mahir-m01/SIMD-Vector-Processing-Unit/reports/src/figures/fpga.pdf

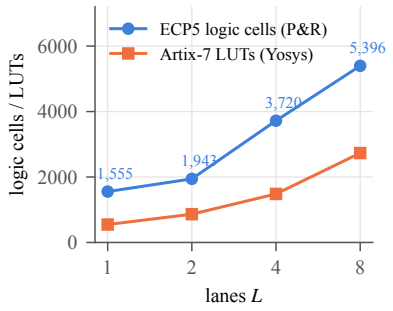
[picture p3: figure]
logic cells / LUTs; ECP5 logic cells (P&R) Artix-7 LUTs (Yosys)
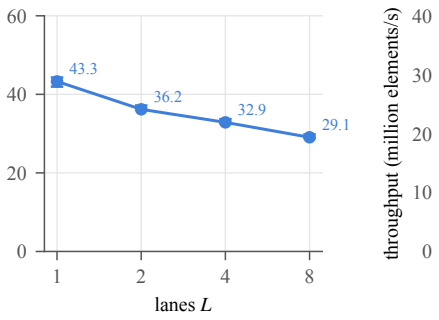
[picture p4: figure]
throughput (million elements/s)
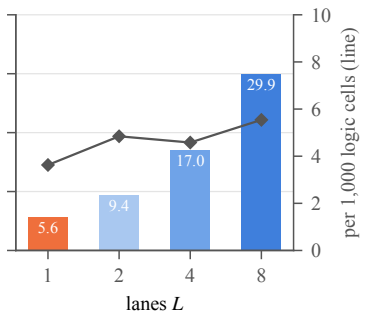
[picture p5: figure]
per 1,000 logic cells (line)

## Fmax on ECP5-25F (MHz)
