mahir-m01/SIMD-Vector-Processing-Unit/reports/src/figures/perf.pdf

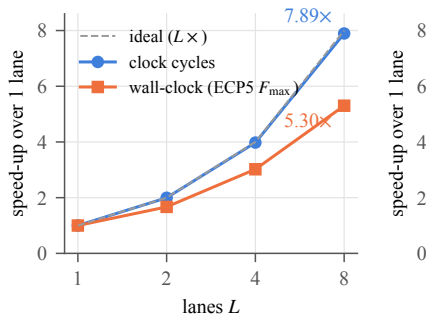
[picture p13: figure]
speed-up over 1 lane; ) clock cycles wall-clock (E C
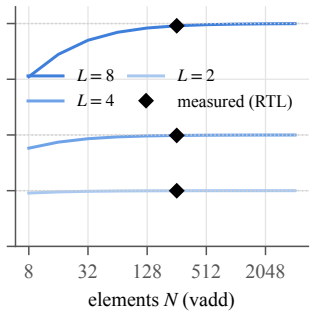
[picture p14: figure]
512 2048 elements N (vadd); 2 measured (RTL)

vadd | saxpy | relu threshold dot

0

1000

2000

## clock cycles (N = 256)

7.92×

7.90×
7.89×

7.87×
7.89×

1 lane (scalar)
2 lanes

4 lanes
8 lanes
