mahir-m01/SIMD-Vector-Processing-Unit/results/fpga_artix7.csv

lanes | luts | luts_total | lutram | flip_flops | flip_flops_total | dsp48 | dsp48_total | bram36_equiv | bram36_total | carry4
1 | 548 | 20800 | 22 | 42 | 41600 | 1 | 90 | 0.5 | 50 | 23
2 | 864 | 20800 | 28 | 42 | 41600 | 2 | 90 | 1.0 | 50 | 40
4 | 1483 | 20800 | 38 | 42 | 41600 | 4 | 90 | 2.0 | 50 | 74
8 | 2731 | 20800 | 60 | 43 | 41600 | 8 | 90 | 4.0 | 50 | 127
