mahir-m01/SIMD-Vector-Processing-Unit/results/fpga_ecp5.csv

lanes | logic_cells | logic_cells_total | flip_flops | lutram_blocks | multipliers | multipliers_total | block_ram | block_ram_total | fmax_mhz_median | fmax_mhz_min | fmax_mhz_max
1 | 1555 | 24288 | 16 | 26 | 1 | 28 | 2 | 56 | 43.29 | 41.96 | 44.29
2 | 1943 | 24288 | 16 | 34 | 2 | 28 | 3 | 56 | 36.19 | 36.13 | 37.17
4 | 3720 | 24288 | 16 | 50 | 4 | 28 | 5 | 56 | 32.87 | 32.67 | 33.69
8 | 5396 | 24288 | 16 | 82 | 8 | 28 | 9 | 56 | 29.07 | 28.85 | 29.81
