mahir-m01/SIMD-Vector-Processing-Unit/results/perf.csv

workload | lanes | elements | instructions | cycles | status | speedup | elements_per_cycle
vadd | 1 | 256 | 1539 | 2051 | PASS | 1.0 | 0.1248
saxpy | 1 | 256 | 1796 | 2308 | PASS | 1.0 | 0.1109
relu | 1 | 256 | 1283 | 1539 | PASS | 1.0 | 0.1663
threshold | 1 | 256 | 1797 | 2053 | PASS | 1.0 | 0.1247
dot | 1 | 256 | 1540 | 2052 | PASS | 1.0 | 0.1248
isa_test | 1 | 32 | 2918 | 2982 | PASS | 1.0 | 0.0107
vadd | 2 | 256 | 771 | 1027 | PASS | 1.997 | 0.2493
saxpy | 2 | 256 | 900 | 1156 | PASS | 1.997 | 0.2215
relu | 2 | 256 | 643 | 771 | PASS | 1.996 | 0.332
threshold | 2 | 256 | 901 | 1029 | PASS | 1.995 | 0.2488
dot | 2 | 256 | 772 | 1028 | PASS | 1.996 | 0.249
isa_test | 2 | 32 | 1462 | 1494 | PASS | 1.996 | 0.0214
vadd | 4 | 256 | 387 | 515 | PASS | 3.983 | 0.4971
saxpy | 4 | 256 | 452 | 580 | PASS | 3.979 | 0.4414
relu | 4 | 256 | 323 | 387 | PASS | 3.977 | 0.6615
threshold | 4 | 256 | 453 | 517 | PASS | 3.971 | 0.4952
dot | 4 | 256 | 388 | 516 | PASS | 3.977 | 0.4961
isa_test | 4 | 32 | 734 | 750 | PASS | 3.976 | 0.0427
vadd | 8 | 256 | 195 | 259 | PASS | 7.919 | 0.9884
saxpy | 8 | 256 | 228 | 292 | PASS | 7.904 | 0.8767
relu | 8 | 256 | 163 | 195 | PASS | 7.892 | 1.3128
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
