mahir-m01/SIMD-Vector-Processing-Unit/syn/vivado/basys3.xdc

## =============================================================================
## basys3.xdc - pin map for the Digilent Basys-3 board
## =============================================================================
## clk      100 MHz board oscillator
## rst      centre push button (BTNC)
## sel[2:0] switches SW0..SW2: which scalar register to show
## led[7:0] LEDs LD0..LD7: low 8 bits of that register
## done     LED LD15: program finished
## =============================================================================

set_property -dict {PACKAGE_PIN W5  IOSTANDARD LVCMOS33} [get_ports clk]
create_clock -period 10.000 -name sys_clk [get_ports clk]

set_property -dict {PACKAGE_PIN U18 IOSTANDARD LVCMOS33} [get_ports rst]

set_property -dict {PACKAGE_PIN V17 IOSTANDARD LVCMOS33} [get_ports {sel[0]}]
set_property -dict {PACKAGE_PIN V16 IOSTANDARD LVCMOS33} [get_ports {sel[1]}]
set_property -dict {PACKAGE_PIN W16 IOSTANDARD LVCMOS33} [get_ports {sel[2]}]

set_property -dict {PACKAGE_PIN U16 IOSTANDARD LVCMOS33} [get_ports {led[0]}]
set_property -dict {PACKAGE_PIN E19 IOSTANDARD LVCMOS33} [get_ports {led[1]}]
set_property -dict {PACKAGE_PIN U19 IOSTANDARD LVCMOS33} [get_ports {led[2]}]
set_property -dict {PACKAGE_PIN V19 IOSTANDARD LVCMOS33} [get_ports {led[3]}]
set_property -dict {PACKAGE_PIN W18 IOSTANDARD LVCMOS33} [get_ports {led[4]}]
set_property -dict {PACKAGE_PIN U15 IOSTANDARD LVCMOS33} [get_ports {led[5]}]
set_property -dict {PACKAGE_PIN U14 IOSTANDARD LVCMOS33} [get_ports {led[6]}]
set_property -dict {PACKAGE_PIN V14 IOSTANDARD LVCMOS33} [get_ports {led[7]}]

set_property -dict {PACKAGE_PIN L1  IOSTANDARD LVCMOS33} [get_ports done]

## Board configuration voltage
set_property CONFIG_VOLTAGE 3.3 [current_design]
set_property CFGBVS VCCO [current_design]
