mahir-m01/SIMD-Vector-Processing-Unit/(notices)

Notices in the files:
README.md:
Licence: MIT
